ual-arm/ual-ecar-docs/README.md

# ual-ecar-docs
Documentation repository for UAL ecar - See ROS repo: https://github.com/ual-arm-ros-pkg/ual-ecar-ros-pkg/
