ual-arm/ual-ecar-docs/esquemas/Motor_dirección_esquema_electrico.pptx

V_(cc)

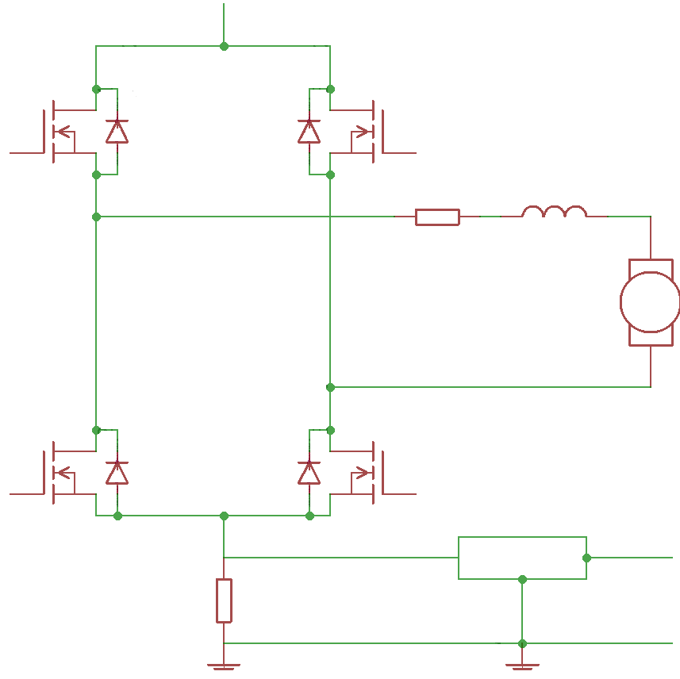
[picture p1: figure]

Q_11

Q_21

R_1

L

e_(motor) (t)

Q_21

Q_12

Filtro

R_2
