ual-arm/ual-ecar-docs/esquemas/Planta_ECARM.pptx

DAQ

Voltímetros

θ

ENC2

PC2

Motor Maxon

Polulu

ENC1

A1

A3

V1

V2

Motor Principal

ENC3

Láser

PC1

V3

A2

A4

δ
