ual-arm/ual-ecar-docs/esquemas/Esquema_bloques_actuador.pptx

Pololu High-Power Motor Driver 36v20 CS

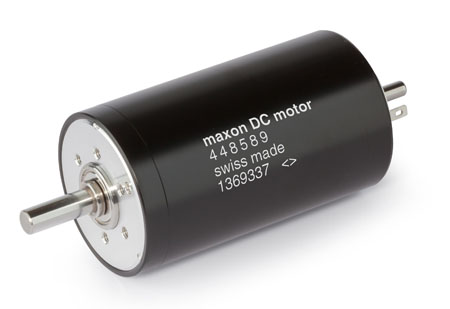
[picture p2: figure]

PWM

V

θ

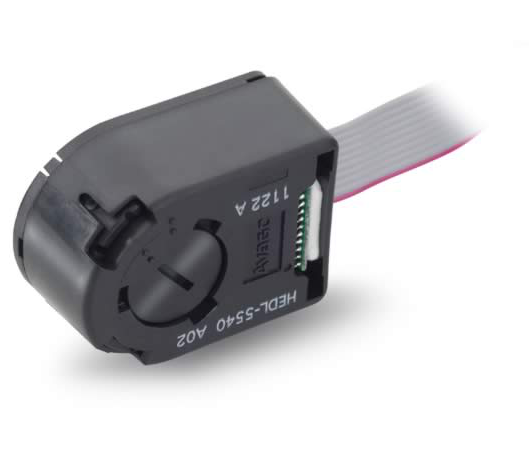
[picture p3: figure]

θ
