ual-arm/ual-ecar-docs/Manual/A0-Paquetes-Formato.tex

%%%%%%%%%%%%%%%%%%%%%%%%%%%%%%%%%%%%%%%%%%%%%%
% PAQUETES
%%%%%%%%%%%%%%%%%%%%%%%%%%%%%%%%%%%%%%%%%%%%%%
\usepackage[T1]{fontenc}
\usepackage[spanish,activeacute] {babel}
\usepackage[utf8]{inputenc}
\usepackage{lmodern} \normalfont %to load T1lmr.fd 

\usepackage{hyperref}
\usepackage{float}
\usepackage{amssymb,amsmath,amsbsy} % símbolo
\usepackage{upgreek} % para poner letras griegas sin cursiva
\usepackage{cancel}
\usepackage{cite}
\usepackage{mathdots} % para el comando \iddots
\usepackage{mathrsfs} % para formato de letra
\usepackage{stackrel} % para el comando \stackbin
\usepackage{graphicx}
\usepackage{subfig}
\usepackage{tabulary}
\usepackage{booktabs}
\usepackage{setspace}
\usepackage{vmargin}
\usepackage{enumitem}
\usepackage{acronym}
\usepackage{url}
\usepackage{pdfpages}
\usepackage{multirow}
\usepackage{bookmark}
\usepackage[toc,page, title, titletoc]{appendix}
\usepackage{blindtext}
\usepackage[labelsep=period]{caption}
\usepackage{listings} % Para el código 
%%%%%%%%%%%%%%%%%%%%%%%%%%%%%%%%%%%%%%%%%%%%%%
% FORMATO
%%%%%%%%%%%%%%%%%%%%%%%%%%%%%%%%%%%%%%%%%%%%%%
% MARGENES
\setmargins	{2.5cm}       % margen izquierdo
			{2.5cm}       % margen superior
			{16.0cm}      % anchura del texto
			{22.2cm}      % altura del texto
			{14.16pt}     % altura de los encabezados
			{1cm}         % espacio entre el texto y los encabezados
			{14.16pt}     % altura del pie de página
			{1cm}         % espacio entre el texto y el pie de página
% CABECERA Y PIE DE PÁGINA
\usepackage{fancyhdr}
\pagestyle{fancy}
\fancyhead[L,C,R,LO]{}
\renewcommand{\headrulewidth}{0.5pt}
\renewcommand{\footrulewidth}{0.5pt}
\fancyhead[RO]{\leftmark}
\fancyhead[LE]{\rightmark}
\fancyhead[RE]{Grupo A.R.M. TEP-197}
\fancyfoot[LE,RO]{\thepage}
\fancyfoot[RE,LO]{UAL-eCARM}
\fancyfoot[C]{}

\fancypagestyle{normal}{
\renewcommand{\headrulewidth}{0.5pt}
\renewcommand{\footrulewidth}{0.5pt}
\fancyhead[LO,RO,LE,RE,C]{}
\fancyfoot[LE,RO]{\thepage}
\fancyfoot[RE,LO]{UAL-eCARM}
}
% Encabezados y pies de página.
\fancypagestyle{plain}{
	\fancyhead[L,C,R]{}
	\fancyfoot[C]{}
	\fancyfoot[L]{UAL-eCARM}
	\fancyfoot[R]{\thepage}
	\renewcommand{\headrulewidth}{0pt}
	\renewcommand{\footrulewidth}{0.5pt}
}
% Estilo creado
\fancypagestyle{blanco}{%
\fancyhead{}
\fancyfoot{}
\renewcommand{\headrulewidth}{0pt}
\renewcommand{\footrulewidth}{0pt}
}
\usepackage{afterpage}
\newcommand\blankpage{
    \null
    \thispagestyle{empty}
    \newpage}
