ual-arm/ual-ecar-docs/Manual/C4-Firmware.tex

%%%%%%%%%%%%%%%%%%%%%%%%%%%%%%%%%%%%%%%%%%%%%%
% Firmware
%%%%%%%%%%%%%%%%%%%%%%%%%%%%%%%%%%%%%%%%%%%%%%
\chapter{Firmware}

\afterpage{\blankpage}
