ual-arm/ual-ecar-docs/Manual/C5-ROS.tex

%%%%%%%%%%%%%%%%%%%%%%%%%%%%%%%%%%%%%%%%%%%%%%
%ROS
%%%%%%%%%%%%%%%%%%%%%%%%%%%%%%%%%%%%%%%%%%%%%%
\chapter{Robot Operating System}
Hablar sobre la estructura de ROS, no hace falta que sea muy detallado el aspecto genérico de ROS. Debe ser suficiente para manejarse con el coche y entender completamente como está estructurado el coche.
\afterpage{\blankpage}
