ual-arm/ual-ecar-docs/Manual/C7-Traccion.tex

%%%%%%%%%%%%%%%%%%%%%%%%%%%%%%%%%%%%%%%%%%%%%%
% Sistema de velocidad longitudinal
%%%%%%%%%%%%%%%%%%%%%%%%%%%%%%%%%%%%%%%%%%%%%%
\chapter{Movimiento longitudinal}
Realizar un análisis detallado de las ecuaciones que rigen la dinámica del vehículo. Estudiar a fondo el Curtis y establecer cual es la configuración más óptima de forma razonada y justificada. Leyendo esta se debe poder manipular el vehículo sin problemas y ser un experto en el asunto.

Al igual que en la dirección se debe realizar la identificación completa y comparativa del vehículo. Estudiar también desde el punto de vista energético.
\afterpage{\blankpage}
