ual-arm/ual-ecar-docs/Manual/C8-Simuladores.tex

%%%%%%%%%%%%%%%%%%%%%%%%%%%%%%%%%%%%%%%%%%%%%%
% Crear herramientas de simulación
%%%%%%%%%%%%%%%%%%%%%%%%%%%%%%%%%%%%%%%%%%%%%%
\chapter{Simuladores}
Crear herramientas de simulación para distintos entornos que permitan estudiar el vehículo offline.
\afterpage{\blankpage}
