ual-arm/ual-ecar-docs/Manual/C9-Control.tex

%%%%%%%%%%%%%%%%%%%%%%%%%%%%%%%%%%%%%%%%%%%%%%
% Arquitectura de control
%%%%%%%%%%%%%%%%%%%%%%%%%%%%%%%%%%%%%%%%%%%%%%
\chapter{Arquitectura de control}
Probad todas las estrategias de control posibles y generar el máximo de papers y congresos. Hay que sacarle rendimiento al coche. Aquí se realizaría un estudio detallado en simulación y experimental de cada estrategia para cada sistema.
\afterpage{\blankpage}
