ual-arm/ual-ecar-docs/esquemas/Esquema_general.pdf

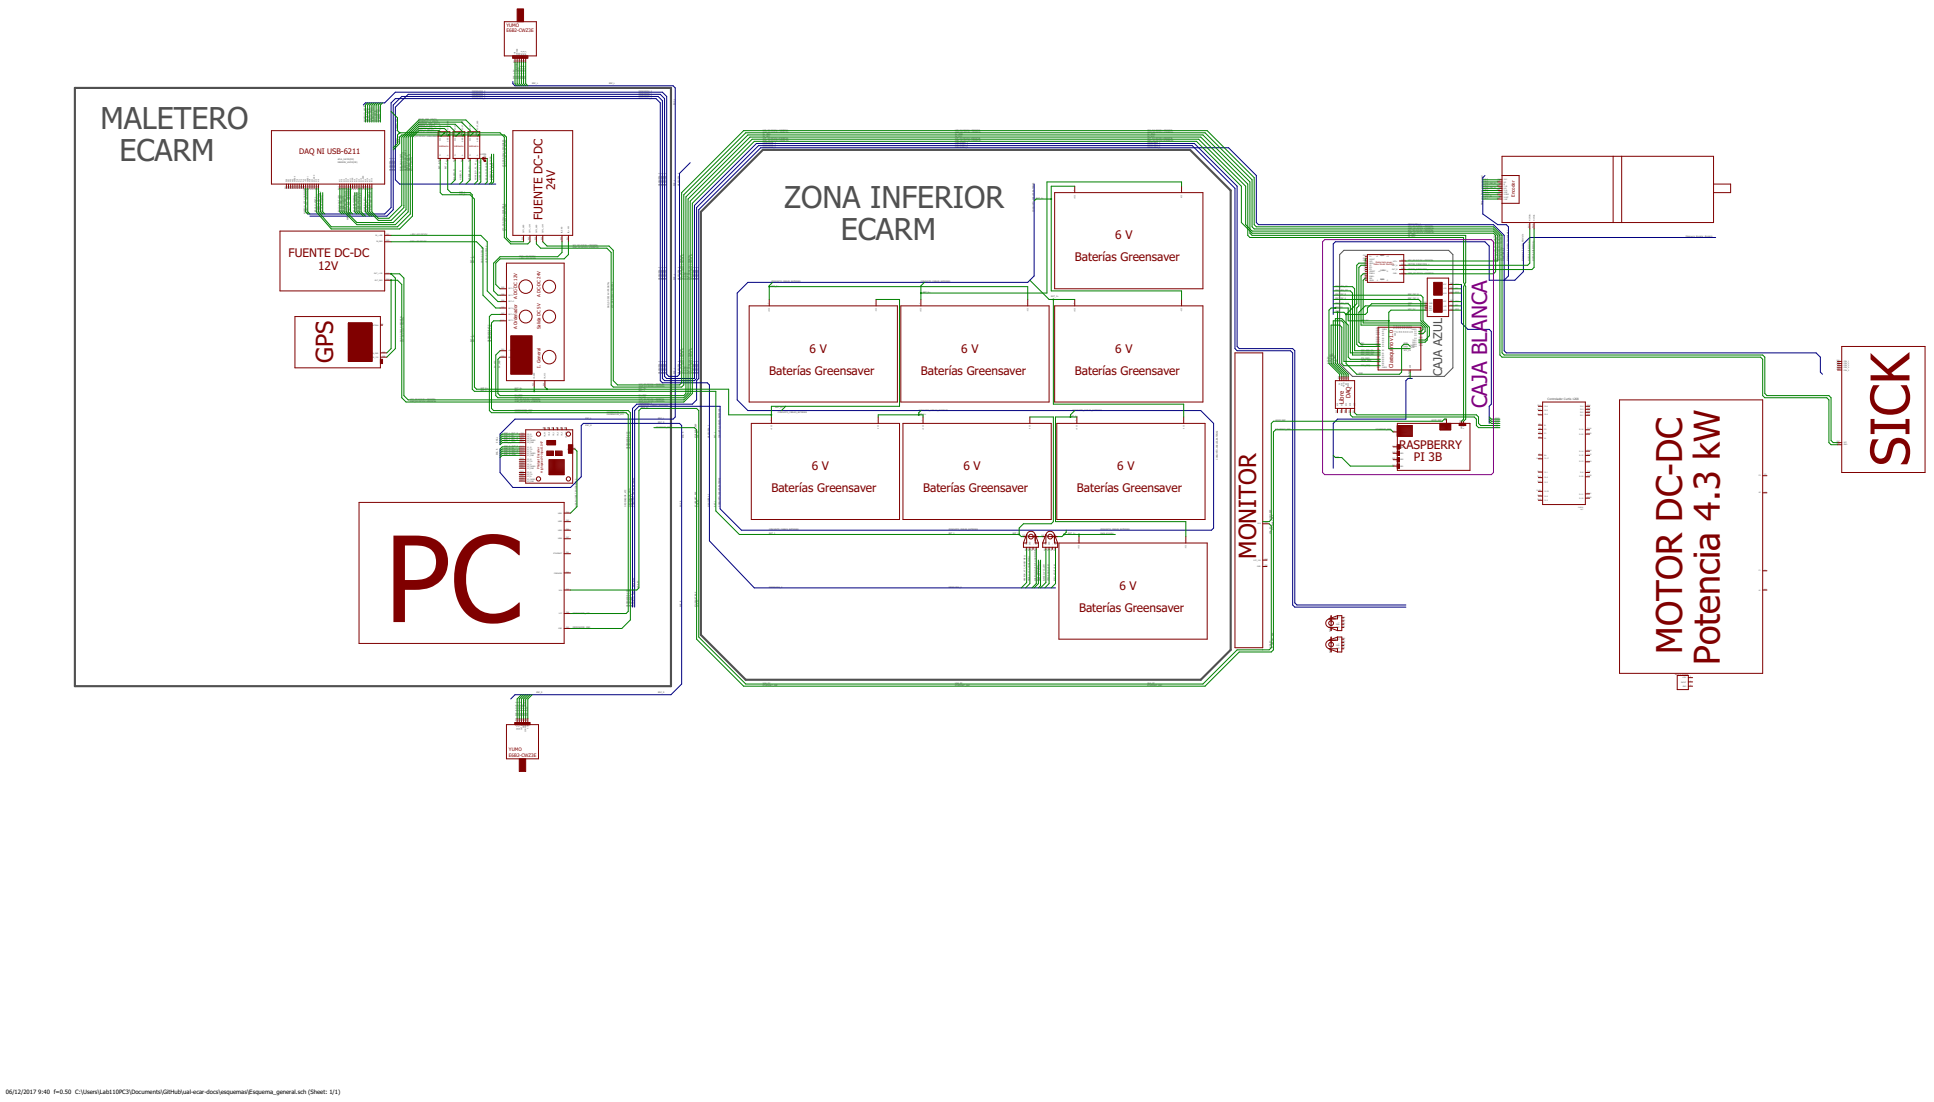
[picture p28: page 1]

FUENTE DC-DC
Pololu high-power Motor Driver 36v20CS G

+48V->DC-DC24V GND->DC-DC24V +48V->DC-DC12V

BAT_5+

GND

GND_DC-DC12V->FRONTAL GND_DC-DC12V->FRONTAL

VCC_DC-DC12V->FRONTAL VCC_DC-DC12V->FRONTAL

Phidget Encoder Highspeed 4-input 1047 PC

06/12/2017 9:40 f=0.50 C:\Users\Lab110PC3\Documents\GitHub\ual-ecar-docs\esquemas\Esquema_general.sch (Sheet: 1/1)
