ual-arm/ual-ecar-docs/esquemas/Conexión_Sensores.sch

## EAGLE design esquemas/Conexión_Sensores.sch (2017-05-26)

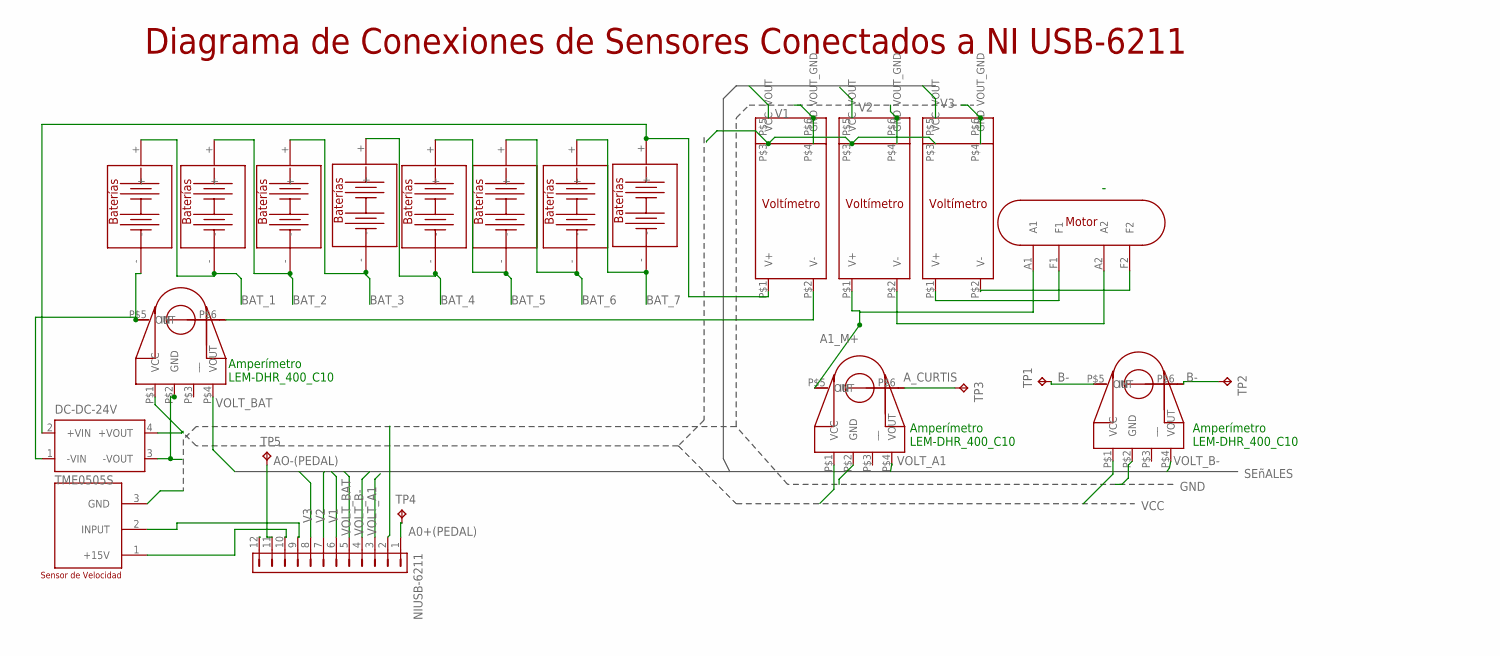
[picture p29: schematic Conexión_Sensores.sch]

Parts:
AMPERIMETRO_1, AMPERIMETRO_2: AMPERIMETRO
DC-DC-24V: TME0505S; TME
NIUSB-6211: FH21-12S-1DSA
TP1, TP3, TP4, TP5: P1-13
TP2: TPPAD1-13; P1-13
U$1: AMPERIMETRO
U$2, U$3, U$6, U$7, U$8, U$9, U$10, U$11: BATERIA
U$4: MOTOR_SENSORES
U$5: SENSOR_VELOCIDAD; SENSOR_VEL
V1, V2, V3: VOLTIMETRO

Connections:
A0+(PEDAL): NIUSB-6211.1, TP4.TP
A1_M+: AMPERIMETRO_1.P$5 (IN), U$4.A1, V2.P$1 (V+)
AO-(PEDAL): NIUSB-6211.11, TP5.TP
A_CURTIS: AMPERIMETRO_1.P$6 (OUT), TP3.TP
B-: AMPERIMETRO_2.P$5 (IN), AMPERIMETRO_2.P$6 (OUT), TP1.TP, TP2.TP
BAT_1: U$7.-, U$8.+
BAT_2: U$6.-, U$7.+
BAT_3: U$3.-, U$6.+
BAT_4: U$3.+, U$9.-
BAT_5: U$2.-, U$9.+
BAT_6: U$2.+, U$11.-
BAT_7: U$10.-, U$11.+
GND: AMPERIMETRO_1.P$2 (GND), AMPERIMETRO_2.P$2 (GND), U$5.3 (GND), V1.P$4 (GND), V1.P$6 (VOUT_GND), V2.P$4 (GND), V2.P$6 (VOUT_GND), V3.P$4 (GND), V3.P$6 (VOUT_GND)
unnamed: DC-DC-24V.2 (+VIN), U$10.+, V1.P$1 (V+)
unnamed: U$1.P$6 (OUT), V1.P$2 (V-)
unnamed: DC-DC-24V.3 (-VOUT), U$1.P$2 (GND)
unnamed: U$4.A2, V2.P$2 (V-)
unnamed: U$4.F1, V3.P$1 (V+)
unnamed: U$4.F2, V3.P$2 (V-)
unnamed: DC-DC-24V.1 (-VIN), U$1.P$5 (IN), U$8.-
unnamed: V1.P$3 (VCC), V2.P$3 (VCC), V3.P$3 (VCC)
unnamed: NIUSB-6211.10, U$5.1 (+15V)
unnamed: NIUSB-6211.9, U$5.2 (INPUT)
V1: NIUSB-6211.6, V1.P$5 (VOUT)
V2: NIUSB-6211.7, V2.P$5 (VOUT)
V3: NIUSB-6211.8, V3.P$5 (VOUT)
VCC: AMPERIMETRO_2.P$1 (VCC), U$1.P$1 (VCC)
VOLT_A1: AMPERIMETRO_1.P$4 (VOUT), NIUSB-6211.3
VOLT_B-: AMPERIMETRO_2.P$4 (VOUT), NIUSB-6211.4
VOLT_BAT: NIUSB-6211.5, U$1.P$4 (VOUT)

Notes on the sheet:
Diagrama de Conexiones de Sensores Conectados a NI USB-6211
Amperímetro LEM-DHR_400_C10
