ual-arm/ual-ecar-docs/esquemas/Esquema_CURTIS.sch

## EAGLE design esquemas/Esquema_CURTIS.sch (2017-05-26)

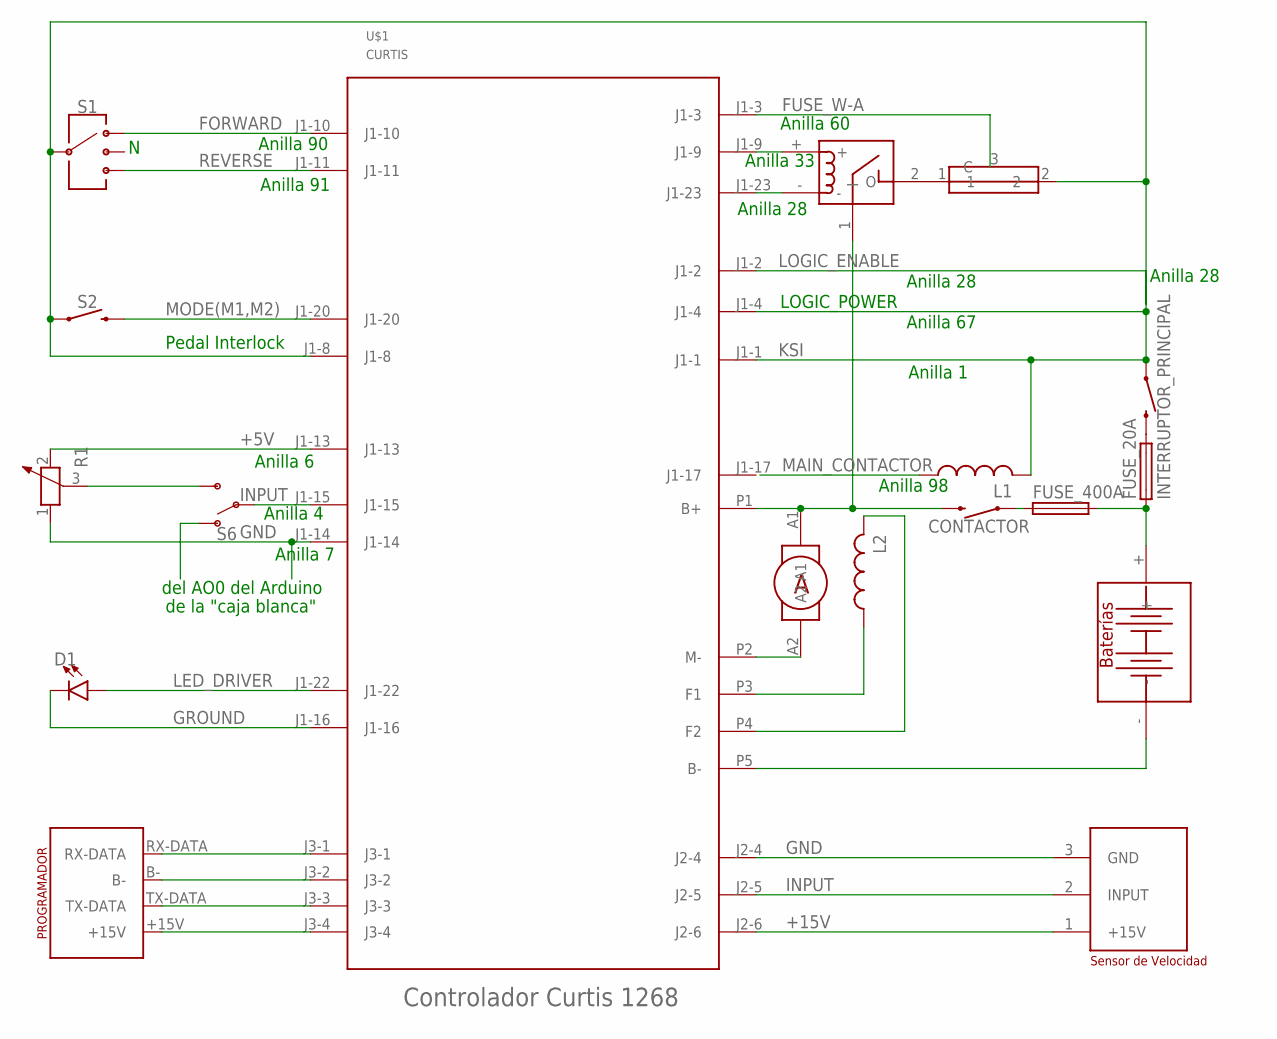
[picture p30: schematic Esquema_CURTIS.sch]

Parts:
CONTACTOR: TACTILE_SWITCH_PTH_6.0MM
D1: LED-3MM-NO_SILK; LED_3MM-NS
FUSE_20A, FUSE_400A: GSH15
INTERRUPTOR_PRINCIPAL: TACTILE_SWITCH_PTH_6.0MM
L1, L2: L-US0204/5; 0204/5
R1: POTENTIOMETER_PT-10S; PT-10S
S1: SWITCH-SP3T-SMD; SWITCH_SP3T_SMD
S2: TACTILE_SWITCH_PTH_6.0MM
S6: SWITCH-SPDT-PTH-11.6X4.0MM; SWITCH_SPDT_PTH_11.6X4.0MM
U$1: CURTIS
U$2: MOTOR
U$3: PROGRAMADOR
U$4: SENSOR_VELOCIDAD; SENSOR_VEL
U$5: BATERIA
U$6: RELE
U$7: FUSIBLE_R

Connections:
+5V: R1.2, U$1.J1-13
+15V: U$4.1 (+15V)
FORWARD: S1.1, U$1.J1-10
FUSE_W-A: U$1.J1-3, U$7.3 (C)
GND: R1.1, U$1.J1-14, U$4.3 (GND)
GROUND: D1.K (C), U$1.J1-16
INPUT: S6.2, U$1.J1-15, U$4.2 (INPUT)
KSI: INTERRUPTOR_PRINCIPAL.1, L1.2, S1.3, S2.1, U$1.J1-1, U$1.J1-4, U$1.J1-8, U$7.2
LED_DRIVER: D1.A, U$1.J1-22
LOGIC_ENABLE: U$1.J1-2
MAIN_CONTACTOR: L1.1
MODE(M1,M2): S2.3 (2), U$1.J1-20
unnamed: CONTACTOR.3 (2), U$1.P1 (B+), U$2.A1, U$6.1 (I)
unnamed: U$6.2 (O), U$7.1
unnamed: CONTACTOR.1, FUSE_400A.1
unnamed: FUSE_20A.2, INTERRUPTOR_PRINCIPAL.3 (2)
unnamed: R1.3, S6.3 (S)
unnamed: U$1.P5 (B-), U$5.-
unnamed: U$1.J3-1, U$3.RX-DATA
unnamed: U$1.J3-2, U$3.B-
unnamed: U$1.J1-9, U$6.+
unnamed: U$1.J3-3, U$3.TX-DATA
unnamed: U$1.J1-23, U$6.-
unnamed: U$1.J3-4, U$3.+15V
unnamed: FUSE_20A.1, FUSE_400A.2, U$5.+
REVERSE: S1.4, U$1.J1-11

Notes on the sheet:
Anilla 60
Anilla 33
Anilla 28
del AO0 del Arduino
de la "caja blanca"
Anilla 1
Anilla 98
Pedal Interlock
Anilla 6
Anilla 7
Anilla 4
Anilla 90
Anilla 91
Anilla 67
LOGIC_POWER
