ual-arm/ual-ecar-docs/esquemas/Esquema_PowerBox1.sch

## EAGLE design esquemas/Esquema_PowerBox1.sch (2017-05-26)

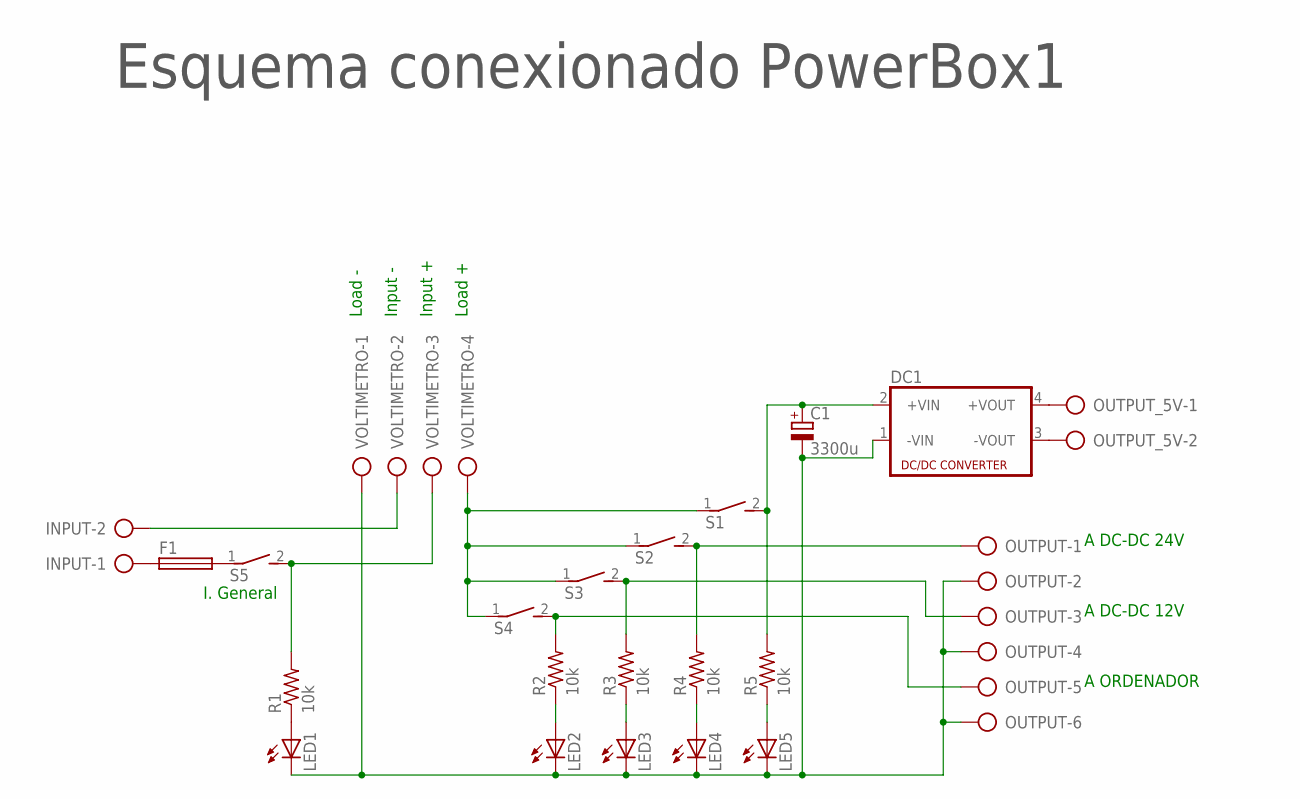
[picture p31: schematic Esquema_PowerBox1.sch]

Parts:
C1: 3300u; 150CLZ-1014
DC1: NME
F1: PICOFUSE
INPUT: AK500/2
LED1, LED2, LED3, LED4, LED5: LEDB155; Q62902-B155
OUTPUT: AK500/6
OUTPUT_5V: AK500/2
R1, R2, R3, R4, R5: 10k; 0207/7
S1, S2, S3, S4, S5: DS01E; DS-01
VOLTIMETRO: AK500/4

Connections:
unnamed: F1.1, INPUT.1
unnamed: INPUT.2, VOLTIMETRO.2
unnamed: LED5.A, R5.1
unnamed: LED1.A, R1.1
unnamed: LED2.A, R2.1
unnamed: LED3.A, R3.1
unnamed: LED4.A, R4.1
unnamed: F1.2, S5.1
unnamed: OUTPUT.3, R3.2, S3.2
unnamed: OUTPUT.1, R4.2, S2.2
unnamed: C1.+, DC1.2 (+VIN), R5.2, S1.2
unnamed: S1.1, S2.1, S3.1, S4.1, VOLTIMETRO.4
unnamed: C1.-, DC1.1 (-VIN), LED1.K (C), LED2.K (C), LED3.K (C), LED4.K (C), LED5.K (C), OUTPUT.2, OUTPUT.4, OUTPUT.6, VOLTIMETRO.1
unnamed: OUTPUT.5, R2.2, S4.2
unnamed: DC1.4 (+VOUT), OUTPUT_5V.1
unnamed: DC1.3 (-VOUT), OUTPUT_5V.2
unnamed: R1.2, S5.2, VOLTIMETRO.3

Notes on the sheet:
A DC-DC 24V
A DC-DC 12V
Input -
Input +
Load -
Load +
I. General
A ORDENADOR
Esquema conexionado PowerBox1
