ual-arm/ual-ecar-docs/esquemas/Esquema_general.sch

## EAGLE design esquemas/Esquema_general.sch (2019-09-28)

Schematic: Esquema_general.sch

Parts:
D1: HLMP6
U$2, U$23: FUENTE_24V
U$3: SENSOR_VELOCIDAD; SENSOR_VEL
U$7: CURTIS
U$8, U$9, U$10, U$11, U$12, U$13, U$14, U$15: BATERIA
U$16: PC
U$17: GPS
U$18, U$19, U$20, U$35: AMPERIMETRO
U$21: POWERBOX
U$22: FUENTE_12V
U$26, U$27: ENCODER_YUMO; ENCODER
U$28: MONITOR
U$29: SICK
U$30: MOTOR_SENSORES
U$31, U$37: MOTOR_DIRECCION
U$32: RELE_ARDUINO
U$33, U$34: POLOLU_HIGH-POWER_MOTOR_DRIVER; POLOLU_HIGH-POWER_MOTOR
U$36: LIBRE_DAQ

Connections:
5V_GND: U$21.P$2 (GND(5V))
5V_VCC: U$21.P$1 (+5V)
+48V->DC-DC12V: U$21.P$6 (OUT+2), U$22.P$1 (IN_+48V)
+48V->DC-DC24V: U$21.P$5 (OUT+1), U$23.P$1 (IN_+48V)
/CS_DAQ: U$36.P$9 (/CS)
AMARILLO_OUTPUT_HONEYWELL: U$35.P$4 (VOUT)
AO+: U$36.P$2 (AO0)
AO-: U$36.P$1 (GND)
AZUL_J1-22_LED+: D1.K
BAT_1: U$9.- (-VCC), U$21.P$3 (IN_GND), U$35.P$5 (IN)
BAT_1+: U$11.+ (+VCC), U$20.P$6 (OUT)
BAT_2+: U$10.+ (+VCC), U$11.- (-VCC)
BAT_3+: U$10.- (-VCC), U$13.+ (+VCC)
BAT_4+: U$13.- (-VCC), U$15.+ (+VCC)
BAT_5+: U$8.+ (+VCC), U$15.- (-VCC)
BAT_6+: U$9.+ (+VCC), U$12.- (-VCC)
BAT_7+: U$8.- (-VCC), U$14.+ (+VCC)
BAT_8+: U$12.+ (+VCC), U$14.- (-VCC), U$21.P$4 (IN_VCC)
BLANCO_VCC_LEM: U$20.P$1 (VCC)
CS: U$34.P$8 (CS)
DIR: U$34.P$2 (DIR)
ENC_INC_A: U$37.P$6 (6.A)
ENC_INC_B: U$37.P$8 (B)
ENC_L_5V: U$26.P$1 (5-12V)
ENC_L_COMMON: U$26.P$2 (COMMON)
ENC_L_GND: U$26.P$3 (GND)
ENC_L_OUT_A: U$26.P$4 (OUT_A)
ENC_L_OUT_B: U$26.P$5 (OUT_B)
ENC_L_OUT_Z: U$26.P$6 (OUT_Z)
ENC_R_5V: U$27.P$1 (5-12V)
ENC_R_COMMON: U$27.P$2 (COMMON)
ENC_R_GND: U$27.P$3 (GND)
ENC_R_OUT_A: U$27.P$4 (OUT_A)
ENC_R_OUT_B: U$27.P$5 (OUT_B)
ENC_R_OUT_Z: U$27.P$6 (OUT_Z)
GND: U$32.P$10 (GND), U$34.P$9 (GND1), U$36.P$10 (GND0), U$37.P$3 (3.GND)
GND->DC-DC12V: U$21.P$9 (OUT-2), U$22.P$2 (IN_GND)
GND->DC-DC24V: U$21.P$8 (OUT-1), U$23.P$2 (IN_GND)
GND_DC-DC12V->FRONTAL: U$17.P$3 (IN_GND), U$22.P$4 (OUT_GND), U$34.P$16 (GND-)
GND_DC-DC24V->FRONTAL: U$23.P$6 (OUT2_GND), U$29.P$6 (GND)
GND_DC-DC24V->SENSORES: U$23.P$4 (OUT1_GND)
IN1: U$32.P$8 (IN1)
K1C: U$32.P$6 (K1C)
K1I: U$32.P$5 (K1I)
K1O: U$32.P$4 (K1O)
K2C: U$32.P$3 (K2C)
K2I: U$32.P$2 (K2I)
K2O: U$32.P$1 (K2O)
MARRON_J1-16_LED-: D1.A
MARRON_VCC_HONEYWELL: U$35.P$1 (VCC)
MOSI_DAQ: U$36.P$8 (MOSI)
MOTOR_DIRECCION_+: U$34.P$14 (OUT_A), U$37.P$11 (MOTOR+)
MOTOR_DIRECCION_-: U$34.P$15 (OUT_B), U$37.P$12 (MOTOR-)
unnamed: U$20.P$5 (IN), U$35.P$6 (OUT)
unnamed: U$34.P$10 (VCS), U$34.P$11 (5VOUT)
N.C.: U$37.P$1 (1.NC), U$37.P$4 (4.NC), U$37.P$5 (5./A), U$37.P$7 (7./B), U$37.P$9 (9/I), U$37.P$10 (10.I)
NEGRO_-VCC_HONEYWELL: U$35.P$2 (GND)
ORDENADOR_GND: U$16.P$3 (GND), U$21.P$10 (OUT-3)
ORDENADOR_VCC: U$16.P$8 (VCC), U$21.P$7 (OUT+3)
PWMH: U$34.P$4 (PWMH)
ROJO_VOUT_LEM: U$20.P$4 (VOUT)
SCK_DAQ: U$36.P$7 (SCK)
VCC_5V: U$32.P$7 (VCC), U$36.P$6 (5V), U$37.P$2 (2.VCC)
VCC_DC-DC12V->FRONTAL: U$17.P$2 (IN_12V), U$22.P$3 (OUT_+12V), U$34.P$13 (VCC+)
VCC_DC-DC24V->FRONTAL: U$23.P$5 (OUT2_+24V), U$29.P$7 (VCC)
VCC_DC-DC24V->SENSORES: U$23.P$3 (OUT1_+24V)
VERDE_GND_LEM: U$20.P$2 (GND)
VGA_PC: U$16.P$9 (VGA), U$28.P$3 (VGA)

Notes on the sheet:
ZONA INFERIOR ECARM
Hacia el motor
I. General
Salida DC 5V
A Ordenador
A DC-DC 24V
A DC-DC 12V
MALETERO ECARM
NEGRO
ROJO
BLANCO_24V
Manguera_Encoder_Incremental
Manguera_Encoder_Absoluto
==> Pedal switch!
