ual-arm/ual-ecar-docs/(commit log)

2017-02-23 move to subdir; add another SCH
    [Esquema_CURTIS.sch, Esquema_PowerBox1.sch]
2017-02-24 Modificación
    Modificación del texto en PowerBox1, adición del programador en Curtis y
    redistribución de algunos elementos
    [Esquema_CURTIS.sch, Esquema_PowerBox1.sch]
2017-03-06 Conexión J1-1 a 48V
    Modificación del interruptor denominado "Llave" de J1-1. Se suprime por
    un cable a 48V
    [Esquema_CURTIS.sch]
2017-05-26 Actualización de la documentación
    [Conexión_Sensores.sch, Esquema_CURTIS.sch, Esquema_PowerBox1.sch]
2017-11-29 Modificación para nuevos componentes
    [Esquema_general.sch]
2017-11-29 Actualización
    Se han terminado de crear los componentes situados actualmente en el maletero del vehículo.
    Falta terminar de crear los de la parte frontal, el monitor y el cableado.
    [Esquema_general.sch]
2017-11-29 Suma de componentes
    [Esquema_general.sch]
2017-11-30 Creación de componentes
    Se terminan de crear los componentes existentes actualmente en el vehículo
    [Esquema_general.sch]
2017-11-30 Diagrama baterías
    Finalizada la representación del cableado de la zona de baterías. Cables de cada batería y de la manguera de cables de los dos amperímetros instalados.
    [Esquema_general.sch]
2017-11-30 Conexión de componentes del maletero.
    Aún no está terminado.
    [Esquema_general.sch]
2017-12-01 Actualización de esquema y pdf
    Se crea un pdf para poder visualizar el esquema sin necesidad de Eagle
    [Esquema_general.sch]
2017-12-01 Actualización esquema y pdf
    Se ha concluido el cableado actual del maletero del vehículo eCARM.
    [Esquema_general.sch]
2017-12-05 Cableado Caja Blanca Finalizado
    [Esquema_general.sch]
2017-12-06 Cableado completo Caja Blanca
    [Esquema_general.sch]
2017-12-06 Cableado actual del vehículo eCARM
    [Esquema_general.sch]
2017-12-09 Steer-by-wire. Matlab
    Se añaden los archivos empleados en Matlab para el modelado y diseño del sistema de control Steer-by-wire. Se incluyen los datos recogidos del sistema real y los modelos implementados en Simulink.
2017-12-18 Modificación
    [Esquema_general.sch]
2017-12-19 Sch Lib de Claraquino, cambio de estilo:
    - No mostrar nombres pines PCB (tampoco tiene sentido si no es un componente real).
    - dibujar pines de forma más "estándard": con longitud en vez de puntos.
    [Esquema_general.sch]
2018-01-09 Esquema de distribución de componentes en PowerPoint
2018-01-10 Corrección para los nuevos modelos
2018-01-11 Modificación de componentes e indicadores
2018-02-19 sch eagle: quitar RBPI, añadir cables segundo rele
    TODO: Curtis sch
    [Esquema_general.sch]
2019-09-28 Update Esquema_general.sch
    Primera actualización de componentes.
    [Esquema_general.sch]
2019-12-23 Inicio
    Planteamiento inicial de un manual acerca del vehículo UAL-eCARM
2019-12-23 Planteamiento inicial
    Planteamiento inicial del manual sobre el vehículo UAL-eCARM
2019-12-24 Sección de trabajos anteriores
    Se han indicado los TFG/TFM/Doctorado/Paper/Congresos que han estado relacionados con el vehículo. Seguro que me faltan TFGs y papers, pero es un principio
2019-12-24 Resumen del TFG de Aarón
2019-12-24 Componentes Energía
    Introducción a los componentes involucrados en el aspecto energético del vehículo
2019-12-25 Datasheet
    Creo una carpeta donde almacenar los datasheet de los dispositivos del vehículo
2019-12-25 Correccion de nombres
2019-12-25 Encoder absoluto
2019-12-25 Avance descripción de sensores
2020-04-09 Diagramas de bloques
